MYBLtd/ChaoticVolt-42dB_STM32_DSP_engine/Core/Inc/main.h

#define STLINK_RX_Pin GPIO_PIN_8
#define STLINK_RX_GPIO_Port GPIOD
#define STLINK_TX_Pin GPIO_PIN_9
#define STLINK_TX_GPIO_Port GPIOD
#define PROTOCOL_VERSION 1
