MYBLtd/ChaoticVolt-42dB_STM32_DSP_engine/(commit log)

2026-02-04 Initial commit - 42dB DSP Engine
    I2S audio DSP processor with BLE control on STM32H753.
    Starting point with working ESP32 UART communication.
    Roadmap:
    - [x] ESP32 BLE UART interface
    - [ ] I2S input
    - [ ] I2S output (passthrough)
    - [ ] DSP processing
    - [ ] BLE parameter control
2026-02-05 Working I2S audio passthrough (Build #31)
    - SAI2_A configured as slave RX with RISINGEDGE clock strobing
    - SAI2_B configured as slave TX synced to SAI2_A with FALLINGEDGE
    - DMA buffers in D2 SRAM (required for DMA1/DMA2 access)
    - Audio path: ESP32 BT -> 74HCT04 buffer -> STM32 -> DAC
    Key findings:
    - RX must sample on RISING edge (when TX data is stable)
    - TX outputs on FALLING edge
    - 74HCT04 buffer required to isolate ESP32 from STM32 input load
    - PCM5102A SCK pin must be grounded
2026-02-06 Add GATT command parser for ESP32 BLE control
    - Line buffer accumulates UART data until \r\n
    - Parses "GATT:<char>:<hex>" format from ESP32 UART echo
    - Handles DSP commands: preset, loudness, mute, volume, bypass, bass boost
    - Logs parsed commands with [GATT] and [DSP] prefixes
    Build #32: Full BLE control chain working
    ESP32 BLE -> UART echo -> STM32 parser -> (ready for DSP)
2026-02-06 Add DSP processing: Loudness, Mute, Bypass
    - Loudness: Low-shelf bass boost filter (+6dB @ 150Hz)
    using biquad IIR filter with Audio EQ Cookbook coefficients
    - Mute: Sets audio output to zero
    - Bypass: Direct passthrough, skips all DSP processing
    - Fix UART byte loss by adjusting interrupt priorities:
    UART2 at priority 0, Audio DMA at priority 2
    - Add robust GATT parser to handle occasional character loss
    ESP32 BLE GATT UART now on GPIO4 (TX) / GPIO5 (RX)
    [main.c]
2026-02-06 Add Volume/Device Trim with fixed headroom
    - Device Trim (cmd 0x07): 0-100 value with perceptual dB mapping
    100 → 0dB, 80 → -6dB, 60 → -12dB, 40 → -20dB, 20 → -35dB, 0 → -60dB
    - Fixed -9dB headroom always applied (not dependent on active effects)
    This prevents volume jumps when enabling/disabling Loudness or Bass Boost
    Effects "fill" the headroom rather than reducing volume
    - Smooth gain ramping (~10ms) to prevent clicks/pops on volume changes
    [main.c]
2026-02-06 Add Bass Boost, Duck mode, and Normalizer/DRC
    Bass Boost (cmd 0x09):
    - Low-shelf filter +8dB @ 100Hz
    - For small speakers lacking natural bass
    Duck Mode (cmd 0x05):
    - -12dB gain reduction (~25% volume)
    - Smooth ramping for panic/notification scenarios
    Normalizer/DRC (cmd 0x06):
    - Threshold: -12dB (compress only loud parts)
    - Ratio: 2:1 (gentle compression)
    - Attack: 10ms, Release: 80ms
    - Makeup gain: +3dB
    - Smoothed gain changes for transparent leveling
    DSP chain order:
    1. Loudness → 2. Bass Boost → 3. DRC → 4. Trim → 5. Duck → 6. Mute → 7. Limiter
2026-02-06 Add DSP presets: OFFICE, FULL, NIGHT, SPEECH
    Presets with distinct EQ profiles:
    - OFFICE: Neutral + subtle high-shelf +1.5dB @ 6kHz
    - FULL: Bass +4dB @ 120Hz, treble +3dB @ 8kHz ("fun" curve)
    - NIGHT: Bass -3dB @ 150Hz, volume capped at 60%
    - SPEECH: High-pass 150Hz + mid boost +3dB @ 2.5kHz
    Features:
    - Preset EQ applied first in DSP chain
    - NIGHT mode volume cap without permanently modifying trim value
    - Filter states reset on preset change to avoid clicks
    - Up to 2 biquad stages per preset
    [main.c]
2026-02-06 docs: Comprehensive documentation update for v0.3.0
    Complete rewrite of README.md and TECHNICAL.md to document
    the full DSP engine implementation:
    README.md:
    - System overview with architecture diagram
    - Complete hardware wiring guide (I2S, UART, power)
    - Pin summary with Nucleo header locations
    - Build/flash instructions
    - Full GATT command reference
    - DSP signal chain and filter parameters
    - Troubleshooting guide
    TECHNICAL.md:
    - Detailed peripheral configuration
    - Clock edge timing explanation
    - DMA memory placement (D2 SRAM requirement)
    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
2026-02-06 docs: Add planned BM83 architecture diagram
    Added second architecture diagram showing BM83SM1-00AB as A2DP
    I2S master with ESP32 retained for BLE GATT control.
2026-02-07 fix: Auto-recovery for DMA drift causing audio crackling
    ESP32 I2S clock drift causes RX/TX DMA positions to slowly diverge.
    After several minutes the offset exceeds half a buffer, causing
    crackling audio that previously required a manual reset.
    New SAI_DMA_Resync() monitors the DMA NDTR offset every 500ms and
    automatically restarts SAI/DMA when drift exceeds ±50 samples.
    Resync count is reported in the audio status line.
    [main.c]
2026-02-14 feat: IN-13 nixie bargraph VU meter via DAC1 (PA4)
    Add real-time audio level display using Soviet IN-13 neon bargraph tube
    driven by MPSA42 current sink controlled from STM32 DAC. RMS detection
    with asymmetric attack/release, sqrt compression for natural response,
    and startup prime burst for reliable bottom-up glow initiation.
    - DAC1 Channel 1 on PA4 with calibrated range (770mV-1840mV)
    - HAL_DAC module enabled, MSP init for PA4 analog mode
    - VU works in all modes including bypass
    - Documentation updated for v0.4.0
2026-02-16 feat: Add sine test mode (0x0A) and tighten DMA drift threshold
    Lower DMA drift threshold from 50 to 20 samples for earlier correction.
    Add 1kHz sine test mode (GATT cmd 0x0A) to diagnose input vs output
    audio issues — confirmed ESP32 antenna interference as stutter cause.
    [main.c]
2026-02-18 fix: Migrate I2S from SAI2 (PD pins) to SAI1 (PE pins) and fix TX DMA alignment
    SAI peripheral migration:
    - SAI2_A/B → SAI1_A/B throughout firmware and MSP
    - GPIO: PD11/PD12/PD13/PA0 → PE6/PE4/PE5/PE3 (AF10→AF6)
    - DMA requests: DMA_REQUEST_SAI2_A/B → DMA_REQUEST_SAI1_A/B
    - Matches Nucleo-144 silkscreen SAI labels; compatible with future STM32F446 PCB
    TX DMA alignment fix:
    - TX DMA now starts from first HAL_SAI_RxCpltCallback instead of main()
    - RX DMA has just wrapped to position 0 at that moment → zero initial offset
    - Eliminates RX/TX half-buffer race condition; drift stays at 0..1 samples
    - Verified: 100,000+ buffers, 0 overruns, 0 resyncs, drift never exceeds 1
    Version bump: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
    [main.c]
2026-02-18 feat: Add ESP32 v2.4.1 firmware and fix BLE status notifications
    ESP32 firmware (v2.4.1):
    - Larger I2S ring buffer (32KB), 50ms pre-buffering, dma_frame_num=480
    - Modem sleep disabled (sdkconfig.defaults CONFIG_BTDM_CTRL_MODEM_SLEEP=n)
    - QoS anti-sniff to keep A2DP connection active
    BLE status notification fix (ble_gatt_dsp.c):
    - Track transient DSP state locally: bass boost, normalizer, bypass,
    mute, duck, volume (previously all flags were always 0x00)
    - FLAGS bit layout: 0x01=Mute, 0x02=Duck, 0x04=Loudness,
    0x08=Normalizer, 0x10=BassBoost, 0x20=Bypass
    - STATUS[3] and GalacticStatus shieldStatus now reflect actual state
    - Volume forwarded to GalacticStatus distortionFieldStrength byte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
    [partitions_ota.csv]
2026-02-18 fix: Correct Bypass/BassBoost bit assignments and STATUS[3] layout (ESP32 v2.4.3)
    Per Protocol.md, shieldStatus bit 4 (0x10) = Bypass, bit 5 (0x20) = Bass Boost.
    Previously swapped — app saw Bass Boost always OFF, Bypass stuck ON.
    STATUS[3] now built with correct Protocol.md layout instead of raw s_dsp_flags copy.
2026-02-18 docs: Comprehensive documentation overhaul for v0.5.0
    - README.md: Correct I2S pin assignments (SAI1 PE5/PE4/PE6/PE3, was SAI2 PD pins)
    Update version to v0.5.0 build 59, add Sine Test (0x0A) to command table,
    add v0.5.0 changelog entry, add AF column to pin summary, improve troubleshooting
    - TECHNICAL.md: Update SAI1 references throughout (was SAI2), correct all pin names
    (PE5/PE4/PE6/PE3, was PD13/PD12/PD11/PA0), add 0x0A command handler entry,
    document TX DMA alignment strategy, add drift monitoring section, add IN-13
    troubleshooting table, update clock config section
    - Protocol.md: Bump version to 2.4.3 (2026-02-18), add 0x0A Sine Test command,
    add v2.4.3 fix note for STATU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
2026-02-18 Cleanup: sync repo with local folder (remove/rename/update files)
    [partitions_ota.csv]
2026-02-19 Update README: link to ESP32 repo instead of snapshot reference
    Related Projects table now points to the dedicated ESP32 repository
    (ChoticVolt-ESP32_I2S_Master_with_BLE_GATT) instead of the snapshot
    folder, keeping the three-project ecosystem cross-references consistent.
2026-02-19 docs: Add v2.3.1 legacy reference in Related Projects
    Note that ESP32 firmware v2.3.1 is the last version with ESP32-side DSP
    processing, removed in v2.4.0 when DSP was migrated to this STM32 engine.
    Useful for standalone use or as a DSP implementation reference.
