MYBLtd/ChaoticVolt-42dB_STM32_DSP_engine/docs/images/IMG_2457.JPG

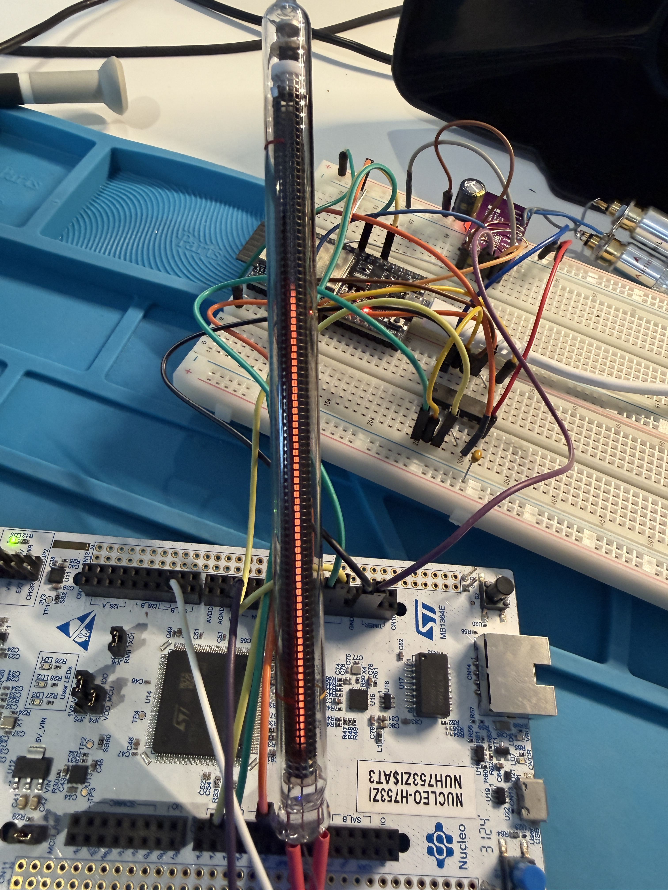
[picture p1: docs/images/IMG_2457.JPG]
docs/images/IMG_2457.JPG
